minou65/NMEA2000-DS1820/img/esp32_pinout-1.jpg

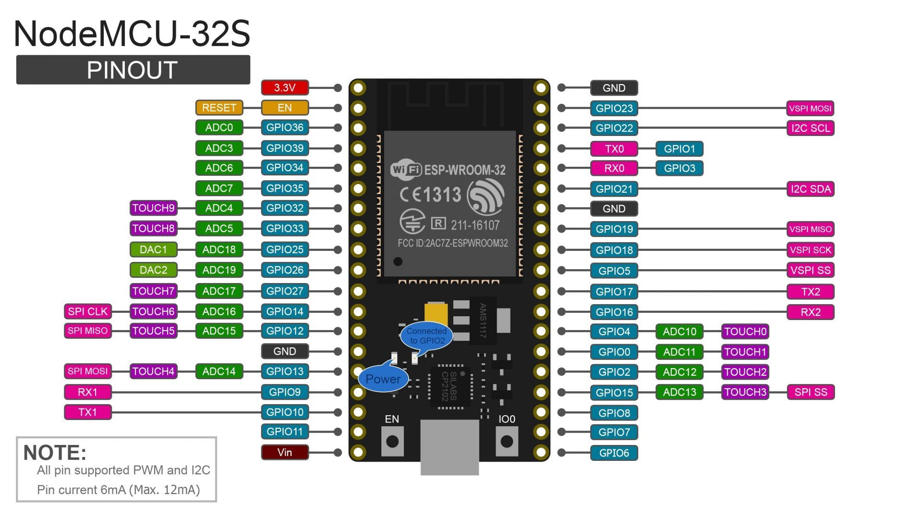
img/esp32_pinout-1.jpg
