minou65/NMEA2000-DS1820/img/IMG_0269.jpeg

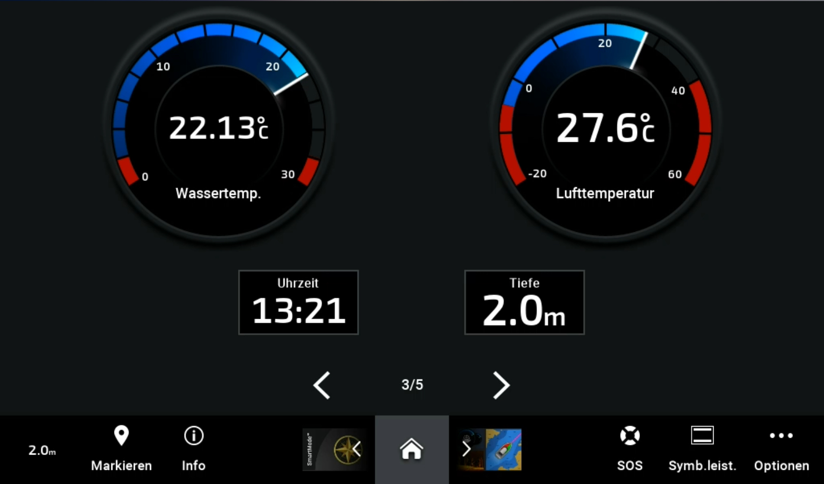
img/IMG_0269.jpeg
