minou65/NMEA2000-DS1820/img/nmea2000-Temperatur.png

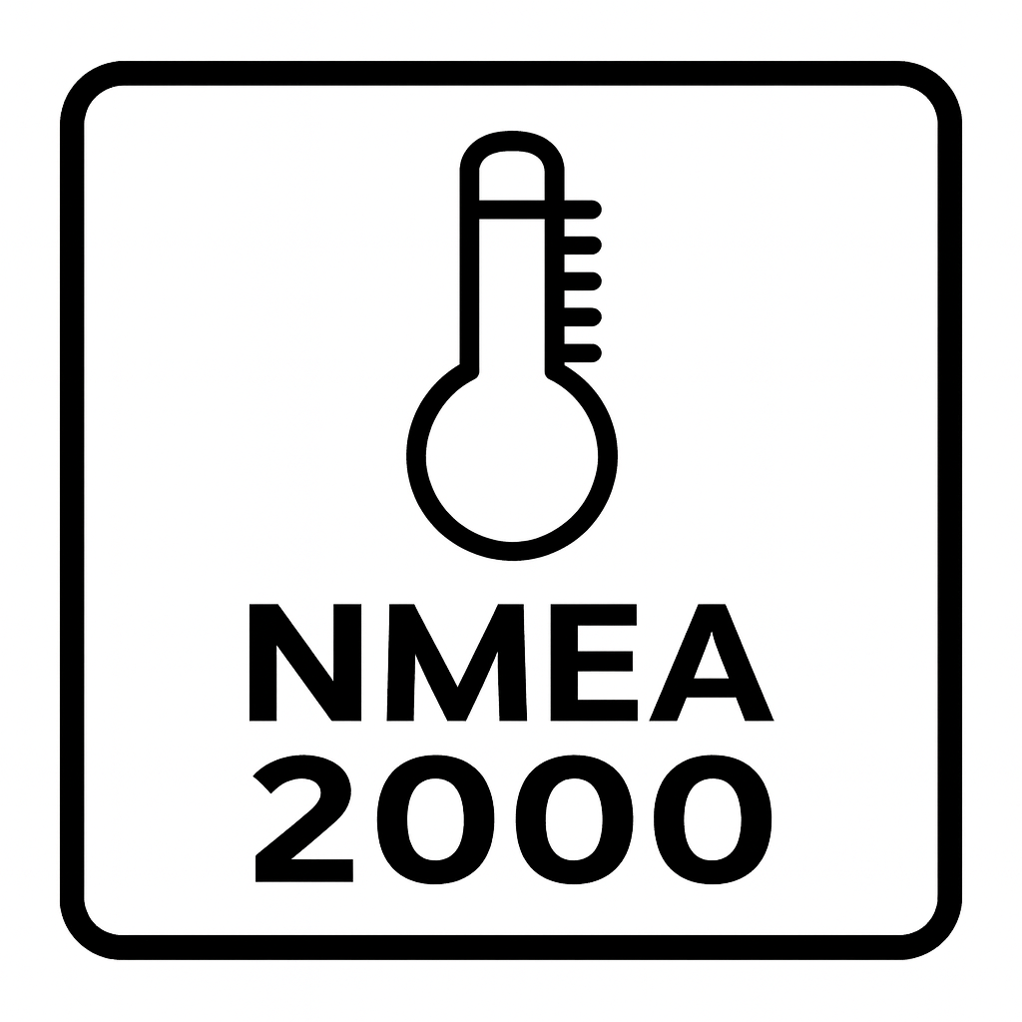
img/nmea2000-Temperatur.png
