minou65/NMEA2000-DS1820/sch/NMEA2000-DS1820.sch

## EAGLE design sch/NMEA2000-DS1820.sch (2024-07-03)

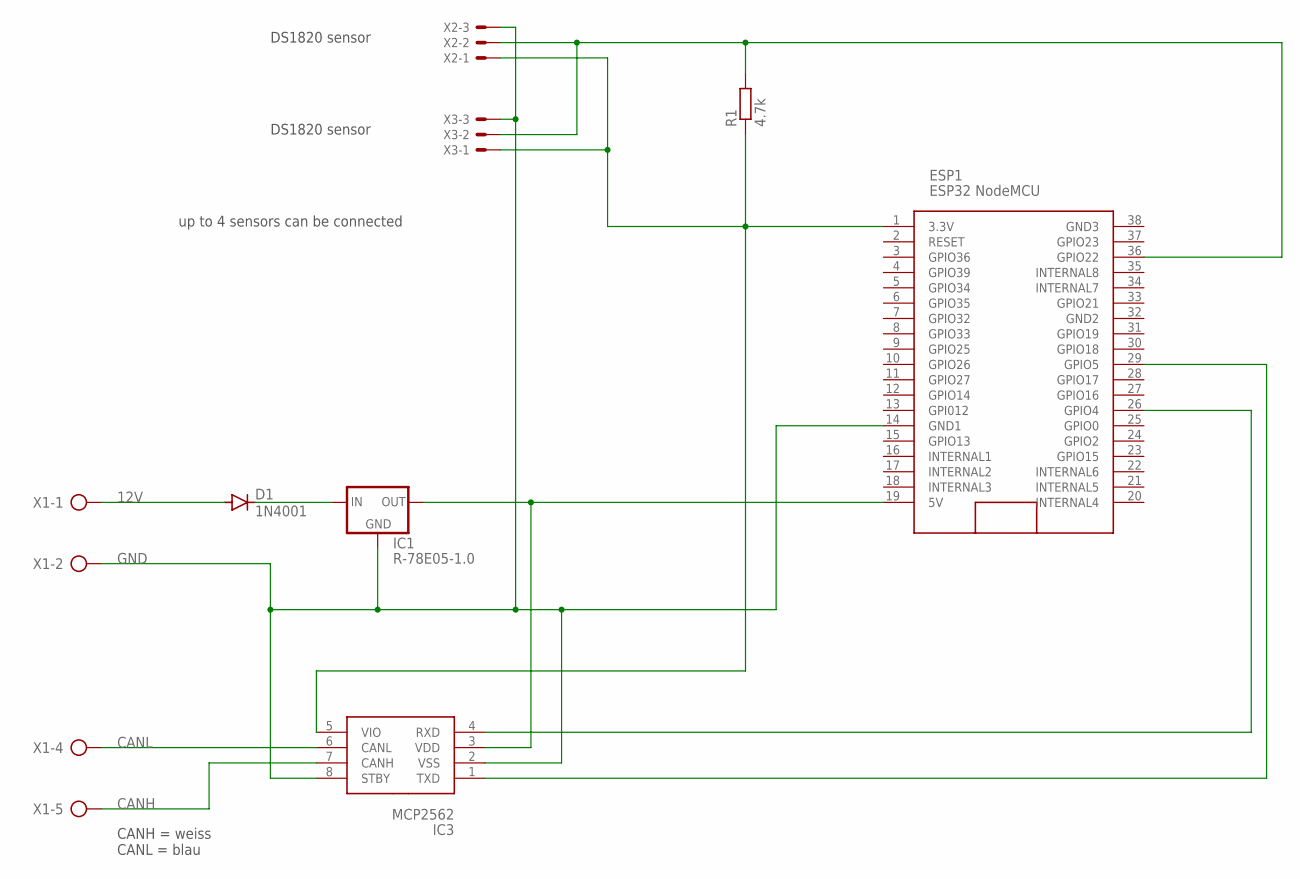
[picture p8: schematic NMEA2000-DS1820.sch]

Parts:
D1: 1N4001; DO41-10
ESP1: ESP32 NodeMCU; ESP32_NODEMCU
IC1: R-78E05-1.0; 78XXS
IC3: MCP2562; DIL08
R1: 4.7k; 0204/7
X1: AK500/5
X2, X3: 22-23-2031

Connections:
12V: D1.A, X1.1
CANH: IC3.7 (CANH), X1.5
CANL: IC3.6 (CANL), X1.4
GND: ESP1.14 (GND1), IC1.GND, IC3.2 (VSS), IC3.8 (STBY), X1.2, X2.3, X3.3
unnamed: ESP1.26 (GPIO4), IC3.4 (RXD)
unnamed: ESP1.29 (GPIO5), IC3.1 (TXD)
unnamed: ESP1.19 (5V), IC1.OUT, IC3.3 (VDD)
unnamed: ESP1.36 (GPIO22), R1.2, X2.2, X3.2
unnamed: D1.C, IC1.IN
unnamed: ESP1.1 (3.3V), IC3.5 (VIO), R1.1, X2.1, X3.1

Notes on the sheet:
CANH = weiss CANL = blau
DS1820 sensor
up to 4 sensors can be connected
