minou65/NMEA2000-DS1820/src/favicon.h

// favicon.h

#ifndef _FAVICON_h
#define _FAVICON_h

const uint8_t favicon_ico[] PROGMEM = { // nmea2000-Temperature_96x96.png
0x89, 0x50, 0x4E, 0x47, 0x0D, 0x0A, 0x1A, 0x0A, 0x00, 0x00, 0x00, 0x0D, 0x49, 0x48, 0x44, 0x52,
0x00, 0x00, 0x00, 0x60, 0x00, 0x00, 0x00, 0x60, 0x08, 0x06, 0x00, 0x00, 0x00, 0xE2, 0x98, 0x77,
0x38, 0x00, 0x00, 0x00, 0x09, 0x70, 0x48, 0x59, 0x73, 0x00, 0x00, 0x0B, 0x13, 0x00, 0x00, 0x0B,
0x13, 0x01, 0x00, 0x9A, 0x9C, 0x18, 0x00, 0x00, 0x09, 0xE8, 0x49, 0x44, 0x41, 0x54, 0x78, 0xDA,
0xED, 0x9D, 0x7B, 0xB0, 0x57, 0x55, 0x15, 0xC7, 0x3F, 0xDF, 0x1F, 0x20, 0x5C, 0x4A, 0x03, 0x7C,
0xDC, 0x9C, 0x2B, 0x6F, 0xA5, 0xC9, 0x9C, 0x42, 0x1B, 0xB4, 0x1C, 0x1F, 0xA9, 0xC5, 0xA8, 0x94,
0x96, 0x51, 0x60, 0x23, 0x69, 0x86, 0x63, 0x2F, 0x1C, 0x6D, 0x34, 0xC3, 0x6C, 0x4A, 0x9B, 0x0A,
0x1C, 0x14, 0xFF, 0x68, 0x7C, 0x12, 0x8D, 0x8E, 0x13, 0x99, 0xAF, 0x31, 0xAB, 0x31, 0xB5, 0xCC,
0xF1, 0x31, 0x18, 0x3E, 0x18, 0x04, 0x46, 0x40, 0x50, 0x54, 0x04, 0x8C, 0x40, 0x79, 0x5E, 0xEF,
0x83, 0xD5, 0x1F, 0x67, 0x1D, 0xEF, 0xF6, 0xCC, 0xF9, 0x3D, 0x2F, 0xF7, 0x77, 0xEF, 0xEF, 0xBA,
0xD7, 0xCC, 0x9E, 0x7D, 0xCE, 0xDA, 0x7B, 0x9D, 0xC7, 0x5E, 0xFB, 0xAC, 0xB5, 0xF6, 0xDA, 0x6B,
0xEF, 0x23, 0x33, 0x23, 0x42, 0xEF, 0x41, 0x21, 0x36, 0x41, 0x64, 0x40, 0x64, 0x40, 0x84, 0xC8,
0x80, 0x0F, 0x2D, 0x0C, 0xAC, 0xA4, 0x92, 0xA4, 0x21, 0xC0, 0x79, 0xC0, 0xA7, 0x63, 0x93, 0x55,
0x04, 0x4B, 0x80, 0x7B, 0xCC, 0xAC, 0xB5, 0x6C, 0x4D, 0x33, 0x2B, 0x9A, 0x9C, 0x41, 0xF7, 0x01,
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
0xFE, 0xB0, 0xD1, 0x19, 0xB0, 0xC3, 0xC7, 0x08, 0x91, 0x01, 0x75, 0x86, 0x9B, 0x83, 0xE3, 0x7B,
0x81, 0x6F, 0x44, 0x06, 0xD4, 0x17, 0x56, 0x93, 0xC4, 0x32, 0x75, 0x02, 0xB7, 0xC4, 0x2F, 0xA0,
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
};
#endif
