minou65/NMEA2000-DS1820/src/common.h

#ifndef _COMMON_h
#define _COMMON_h

extern uint8_t gN2KInstance;
extern uint8_t gN2KSID;
extern uint8_t gN2KSource[];

extern int8_t gDeviceCount;

extern char Version[];
extern bool gParamsChanged;
extern bool gSaveParams;


#endif
