minou65/NMEA2000-DS1820/(commit log)

2023-08-04 initial version
    [NMEA_Temperatursensor.sch]
2023-08-27 Added support for up to 4 sensors
2023-08-27 Reset pin changed
2024-01-02 timers changed
2024-02-29 initial upload
    [NMEA2000-DS1820.sch]
2024-05-01 rest pin changed
2024-07-03 added some missing values
    [NMEA2000-DS1820.sch]
2024-07-26 task watchdog timer added
2024-08-05 Return value temperature rounded to 2 decimal places
2024-08-05 added watch dog timer for core 0 and 1
2024-08-18 Send alert removed due to error in lib
    [NMEA2000-DS1820.ino]
2024-10-08 Updated to ESPAsyncWebServer version 3.3.12 and removed dependency on ArduinoJson
2024-10-09 Should be called befor any device related function is called
2025-04-14 Fix preprocessor directives for platform-specific WiFi includes
    [webhandling.cpp]
2025-04-14 Refactor Watchdog Timer configuration and initialization
2025-05-30 Set ArduinoOTA hostname to the Thing's name after converting parameters
2025-08-20 Fix include order and clean up whitespace in web handling module
    [webhandling.h]
2025-08-20 Refactor Sensor class parameters for consistency and clarity
2025-08-20 Refactor Sensor class constructor and parameters for improved initialization and clarity
2025-08-30 Fix memory management in wifiInit by using dynamic allocation for AsyncWebRequestWrapper
    [webhandling.cpp]
2025-09-01 On system boot, check for all configured sensors and trigger an alert if any are missing. Also improved the alert handling logic for better reliability and clarity.
    [NMEA2000-DS1820.ino, webhandling.cpp, webhandling.h]
2025-09-12 Enhance NMEA2000 device handling by adding support for multiple devices, integrating Preferences for persistent storage, and refining alert system setup.
2026-01-11 Refactor: reverted includes from header file
    [webhandling.h]
2026-02-21 Fix: update response handling for favicon links in handleRoot
    [webhandling.cpp]
2026-05-12 Fix: add missing threshold method value to ThresholdMethodValues
    [webhandling.h]
2026-05-12 Fix: adjust threshold method handling in alert configuration
    [NMEA2000-DS1820.ino]
2026-05-23 Fix: randomize scheduler intervals for improved alert handling
    [webhandling.h]
2026-05-26 Fix: improve alert threshold handling and optimize sensor data sending
    [NMEA2000-DS1820.ino]
2026-05-26 Fix: update sensor data display to use location value instead of source name
    [webhandling.cpp]
2026-05-28 Fix: adjust randomization ranges for scheduler intervals and update SID instance limits
    [webhandling.h]
2026-05-28 Fix: enhance alert system setup for sensors with unique instance handling and improved logging
    [NMEA2000-DS1820.ino]
2026-05-29 Fix: add reboot management functionality and enhance system status display in web interface
    [webhandling.cpp]
2026-05-29 Fix: implement reboot reason logging and enhance watchdog timer management
    [NMEA2000-DS1820.ino]
2026-05-29 Fix: enhance web interface to display pending alerts and improve response stream size
    [webhandling.cpp]
2026-05-31 Fix: remove unnecessary reboot manager load call
    [webhandling.cpp]
2026-05-31 Fix: initialize reboot manager and log reboot count and reason
    [NMEA2000-DS1820.ino]
2026-05-31 Fix: update README for clarity and consistency in temperature units and descriptions
2026-06-06 Fix: address claim bug
    [NMEA2000-DS1820.ino]
2026-06-06 Fix: optimize N2K source address change handling by counting active sensors
    [NMEA2000-DS1820.ino]
2026-06-07 Fix: improve N2K source address change handling and save changes to Preferences
    [NMEA2000-DS1820.ino]
2026-06-22 Fix: update board configuration options and improve error handling for unselected boards
    [NMEA2000-DS1820.ino]
2026-06-22 Fix: add time synchronization and GNSS parsing functionality to NMEA2000 integration
    [NMEA2000-DS1820.ino]
2026-06-22 Fix: add warning for no time update received for 1 hour in loop function
    [NMEA2000-DS1820.ino]
2026-06-22 Fix: update sensor type description to DS18B20 Temperature Sensor in setup output
    [NMEA2000-DS1820.ino]
2026-07-24 Fix: implement max temperature tracking for sensors and update preferences handling
    [NMEA2000-DS1820.ino, webhandling.cpp, webhandling.h]
2026-08-02 feat: update web handling to use tab-based configuration and improve max temperature tracking
2026-08-02 fix: improve max temperature tracking with timestamps
    [NMEA2000-DS1820.ino]
2026-08-02 feat: enhance web handling with reset and reboot functionality
    [webhandling.cpp]
2026-08-04 feat: add max temperature timestamp tracking to sensor data response
2026-08-04 feat: implement MAC-based unique addressing and startup delay for sensors
2026-08-08 feat: enhance MAC-based addressing and startup delay for improved device management
